AidanHockey5/ESP8266_VGM_Player_PSG_YM2612/SchematicsAndInfo/ESP8266_YM2612_SN76489_VGM_Player.pdf

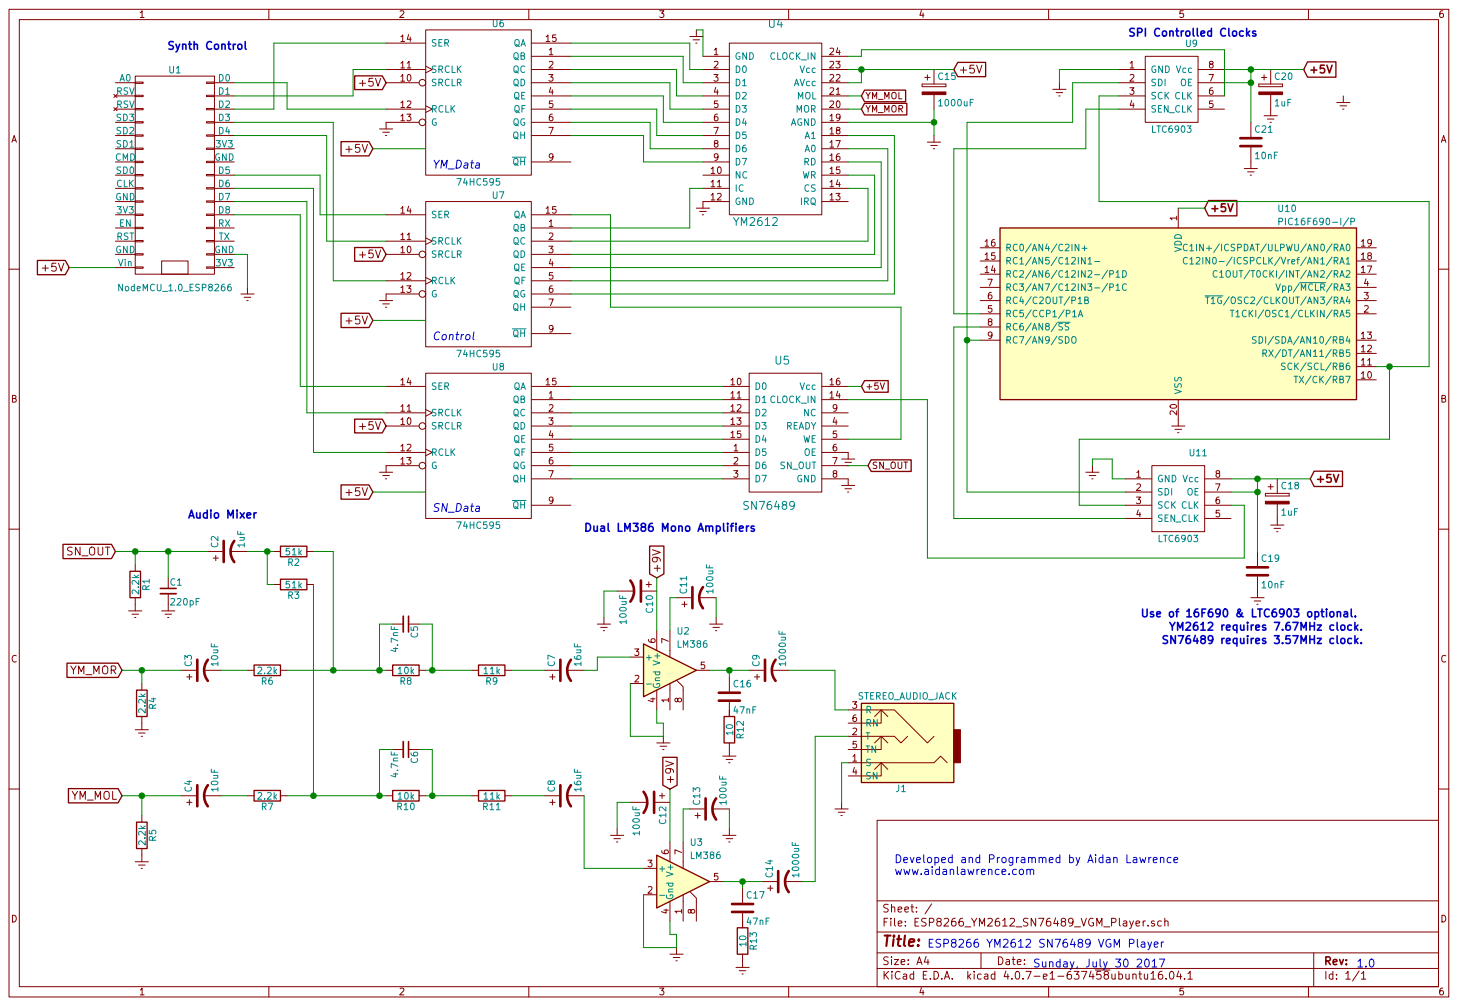
[picture p2: page 1]

1 T1CKI/OSC1/CLKIN/RA5 2 T1G/OSC2/CLKOUT/AN3/RA4 3 Vpp/MCLR/RA3 4 RC5/CCP1/P1A 5 RC4/C2OUT/P1B 6 RC3/AN7/C12IN3-/P1C 7 RC6/AN8/SS 8 RC7/AN9/SDO 9 TX/CK/RB7 10 VSS 20 SCK/SCL/RB6 11 RX/DT/AN11/RB5 12 SDI/SDA/AN10/RB4 13 RC2/AN6/C12IN2-/P1D 14 RC1/AN5/C12IN1- 15 RC0/AN4/C2IN+ 16 C1OUT/T0CKI/INT/AN2/RA2 17 C12IN0-/ICSPCLK/Vref/AN1/RA1 18 C1IN+/ICSPDAT/ULPWU/AN0/RA0 19 U10PIC16F690-I/P SPI Controlled Clocks GND 1 SDI 2 SCK 3 SEN 4
+5V Use of 16F690 & LTC6903 optional.

Developed and Programmed by Aidan Lawrence www.aidanlawrence.com
