AidanHockey5/ESP8266_VGM_Player_PSG_YM2612/(commit log)

2017-07-14 YM2612 jumps to life! It's alive! PCM still not supported yet and there seems to be timing issues, but eureka!
    [ESP8266_VGM_Player_PSG_YM2612.ino]
2017-07-14 Songs are streaming to both the PSG and YM2612 with only a couple minor hitches. A few bugs still need to be ironed out, but we're sounding pretty good here!
    [ESP8266_VGM_Player_PSG_YM2612.ino]
2017-07-14 PSG was delayed for WAY too long. There's where the slowdown is coming from!
    [ESP8266_VGM_Player_PSG_YM2612.ino]
2017-07-15 PCM Buffering and playback now works. Buffer was WAY too small and overflowing.
    [ESP8266_VGM_Player_PSG_YM2612.ino]
2017-07-20 Added command prefetching before waits. Still too slow. Final commit before rewrite
    [ESP8266_VGM_Player_PSG_YM2612.ino]
2017-07-31 Added schematics
2017-07-31 Added KiCad sources
    [ESP8266_YM2612_SN76489_VGM_Player.kicad_pcb, ESP8266_YM2612_SN76489_VGM_Player.sch]
2017-08-04 Removed music.h include and corrected schematic label.
    [ESP8266_YM2612_SN76489_VGM_Player.sch]
2017-08-04 Corrected schematic
    [ESP8266_YM2612_SN76489_VGM_Player.sch]
2017-08-14 Corrected Schematic. Shift registers need their SRCLR pins pulled to VCC
    [ESP8266_YM2612_SN76489_VGM_Player.sch]
2017-08-14 Added new schematics
2017-08-19 Corrected code to match with new schematic.
    [ESP8266_VGM_Player_PSG_YM2612.ino]
